juliofaura/oilmeter/Sensors/HC-SR04/Arduino/Distance-HC-SR04/Distance-HC-SR04.ino

const int trigPin = 9; 
const int echoPin = 10;

const int samples = 3;
const int time_delay = 500;
const int ceiling = 144;

float duration, distance, stick, liters;
int tranch;

const float liters_table[] = {
0,
3.5527328462448,
10.0247326637267,
18.3725529464608,
28.2183707163832,
39.3410291761309,
51.5894296250806,
64.8512518469467,
79.0383716964191,
94.0789905505373,
109.91295336688,
126.488761712572,
143.761564449007,
161.69174861514,
180.243917421517,
199.386128134566,
219.089310343002,
239.32681298639,
260.07404553232,
281.308189439568,
303.007963055353,
325.153427791659,
347.725826648087,
370.707448406554,
394.081512435341,
417.83207021062,
441.943920526747,
466.40253601196,
491.193999054705,
516.304945620071,
541.722515725553,
567.434309571892,
593.428348503432,
619.693040114645,
646.217146933477,
672.989758204295,
700.00026436809,
727.238333898943,
754.693892206211,
782.357102353728,
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
  };
const int liters_table_size = 127;

void setup() {
 pinMode(trigPin, OUTPUT); 
 pinMode(echoPin, INPUT); 
 Serial.begin(9600);
}

void loop() {

  duration = 0;
  for(int i=0; i<samples; i++) {
    digitalWrite(trigPin, LOW);
    delayMicroseconds(2);
    digitalWrite(trigPin, HIGH);
    delayMicroseconds(10);
    digitalWrite(trigPin, LOW);
    duration += pulseIn(echoPin, HIGH);
    delay(time_delay);
  }
  duration /= samples;

  distance = (duration*.0343)/2;
  stick = ceiling-distance;
  if(stick < 0) {
    liters = 0;
  } else if(stick >= liters_table_size) {
    liters = 3000;
  } else {
    tranch = stick;
    liters = liters_table[tranch] + (liters_table[tranch+1] - liters_table[tranch])*(stick - tranch);
  }
  
  
  Serial.print("Duration: ");
  Serial.print(duration);
  Serial.print(", Distance: ");
  Serial.print(distance);
  Serial.print(", Stick: ");
  Serial.print(stick);
  Serial.print("; Liters: ");
  Serial.println(liters);
  
}
