juliofaura/oilmeter/Sensors/VL53L1X/Arduino/Distance-VL53L1X/Distance-VL53L1X.ino

/*
  Reading distance from the laser based VL53L1X
  By: kaloha
  Waveshare Electronics
  VL53L1X Distance Sensor from Waveshare: https://www.waveshare.com/vl53l1x-distance-sensor.htm
  This example demonstrates how to read the distance in short mode(up to 1.3m) and the measurement status.
*/

/*
 * VCC: brown (vcc)
 * GND: yellow (gnd)
 * SCL: red (A5)
 * SDA: orange (A4)
 */
#include <Wire.h> +
#include "VL53L1X.h"

VL53L1X Distance_Sensor;

void setup()
{
  Wire.begin();
//  Wire.setClock(1000); // use 400 kHz I2C

  Serial.begin(9600);
  Serial.println("VL53L1X Distance Sensor tests in short distance mode(up to 1.3m). I2C clock is 1Khz");
  Distance_Sensor.setTimeout(500);
  if (!Distance_Sensor.init())
  {
    Serial.println("Failed to initialize VL53L1X Distance_Sensor!");
    while (1);
  }
  
  // Use long distance mode and allow up to 50000 us (50 ms) for a measurement.
  // You can change these settings to adjust the performance of the sensor, but
  // the minimum timing budget is 20 ms for short distance mode
  Distance_Sensor.setDistanceMode(VL53L1X::Short);
  Distance_Sensor.setMeasurementTimingBudget(50000);

  // Start continuous readings at a rate of one measurement every 50 ms (the
  // inter-measurement period). This period should be at least as long as the
  // timing budget.
  Distance_Sensor.startContinuous(50);
}

void loop()
{
  Distance_Sensor.read();
  Serial.print("Distance(mm):");
  Serial.print(Distance_Sensor.ranging_data.range_mm);
   Serial.print("\tStatus: ");
  Serial.print(VL53L1X::rangeStatusToString(Distance_Sensor.ranging_data.range_status));
  Serial.println();
}
