juliofaura/oilmeter/(commit log)

2020-01-09 Consolidated everything in github repository
    [Cálculos tanque de gasoleo.ods]
2020-01-13 Added single data file
    [Cálculos tanque de gasoleo.ods]
2021-11-08 Switched to VL53L1X
2026-01-01 Added filtering function for graph
2026-01-05 Added filtering function (in files.go)
